RaspSDR/gpsdo/1.jpg

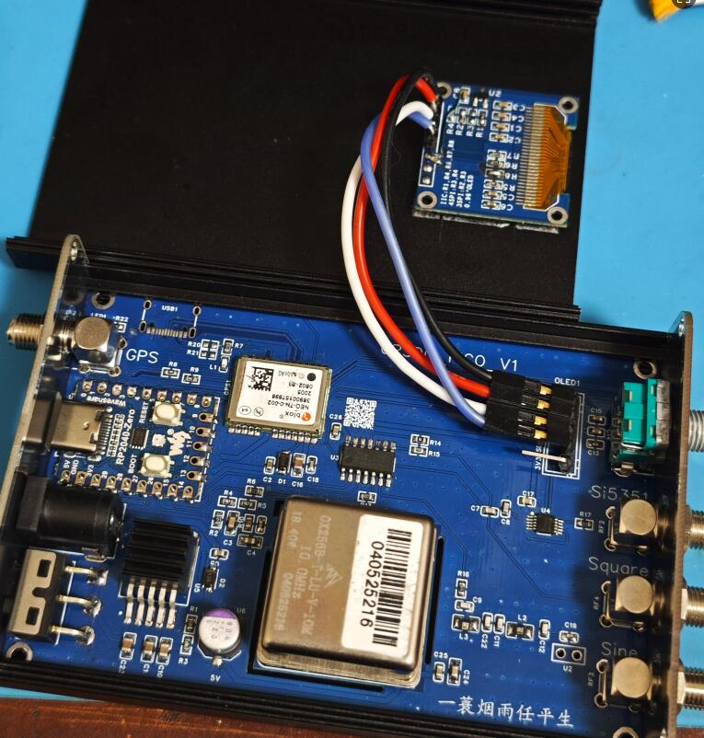
1.jpg
