RaspSDR/gpsdo/2.jpg

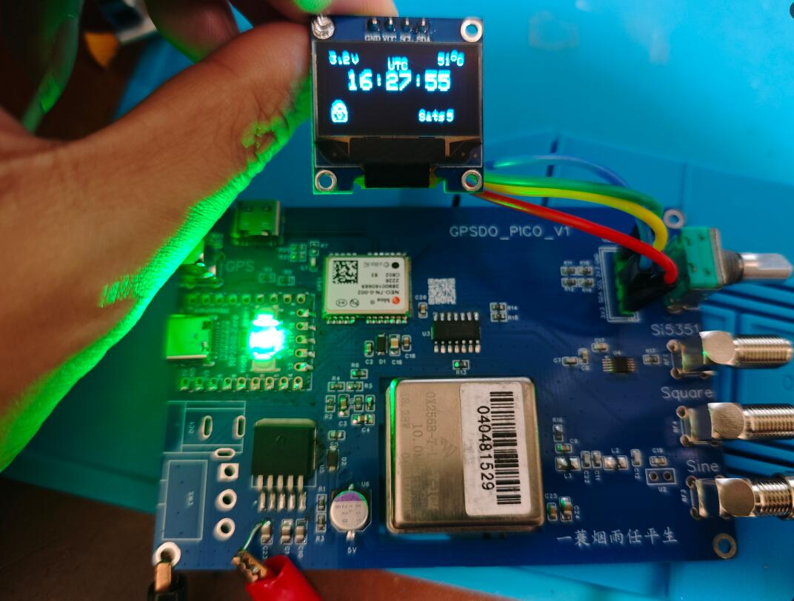
2.jpg
