RaspSDR/gpsdo/BOM_gpsdo_gpsdo_2025-09-10.xlsx

No. | Quantity | Comment | Designator | Footprint | Value | Manufacturer Part | Manufacturer | Supplier Part | Supplier
1 | 4 | 22u | C1,C10,C16,C23 | C0805 | 22u
2 | 11 | 100nF | C2,C5,C6,C13,C14,C15,C17,C18,C19,C25,C26 | C0603 |  | CC0603KRX7R9BB104 | YAGEO | C14663 | LCSC
3 | 3 | 10u | C3,C4,C24 | C0805 | 10u
4 | 2 | 100pF | C7,C8 | C0603 |  | CC0603KRX7R9BB104 | YAGEO | C14663 | LCSC
5 | 3 | 330pF | C9,C12,C22 | C0603 |  | CC0603KRX7R9BB104 | YAGEO | C14663 | LCSC
6 | 1 | 220pF | C11 | C0603 |  | CC0603KRX7R9BB104 | YAGEO | C14663 | LCSC
7 | 2 | B5819WL | D1,D2 | SOD-123F_L2.8-W1.8-LS3.7-RD |  |  | SHIKUES(时科) | C112447 | LCSC
8 | 1 | DC-005-A200 | DC1 | DC-IN-TH_DC-005-A200 |  |  | XUNPU(讯普) | C720557 | LCSC
9 | 1 | NEO-7M-0 | GPS1 | GPS-SMD_NEO-7M-0 |  |  | U-BLOX | C6612031 | LCSC
10 | 1 | 27nH | L1 | L0603 |  |  | muRata(村田) | C162649 | LCSC
11 | 2 | 1uH | L2,L3 | IND-SMD_L2.3-W1.7-1 |  |  | Sunltech(韩国顺磁) | C363974 | LCSC
12 | 1 | XL-1608UGC-04 | LED1 | LED0603-RD_GREEN |  | XL-1608UGC-04 | XINGLIGHT(成兴光) | C965804 | LCSC
13 | 1 | OCXO-5 | O1 | OCXO-5
14 | 1 | DISPLAY-1.54-OLED-128X64-I2C | OLED1 | CONN-TH_XH2.54-5P
15 | 1 | 18K | R1 | R0603 |  | 0603WAF1002T5E | UniOhm | C25804 | LCSC
16 | 1 | 220K | R2 | R0603 |  | 0603WAF1002T5E | UniOhm | C25804 | LCSC
17 | 3 | 56K | R3,R4,R5 | R0603 |  | 0603WAF1002T5E | UniOhm | C25804 | LCSC
18 | 6 | 22R | R6,R8,R9,R11,R12,R13 | R0603 |  | 0603WAF1002T5E | UniOhm | C25804 | LCSC
19 | 1 | 10R | R7 | R0603 |  | 0603WAF1002T5E | UniOhm | C25804 | LCSC
20 | 1 | 75K | R10 | R0603 |  | 0603WAF1002T5E | UniOhm | C25804 | LCSC
21 | 2 | 100R | R14,R15 | R0603 |  | 0603WAF1002T5E | UniOhm | C25804 | LCSC
22 | 2 | 49.9R | R16,R17 | R0603 |  | 0603WAF1002T5E | UniOhm | C25804 | LCSC
23 | 2 | 4.7K | R18,R19 | R0603 |  | 0603WAF1002T5E | UniOhm | C25804 | LCSC
24 | 2 | 5.1K | R20,R21 | R0603 |  | 0603WAF1002T5E | UniOhm | C25804 | LCSC
25 | 2 | 10K | R22,R23 | R0603 |  | 0603WAF1002T5E | UniOhm | C25804 | LCSC
26 | 4 | BWSMA-KWE-Z001 | RF1,RF2,RF3,RF4 | SMA-TH_BWSMA-KWE-Z001 |  |  | BAT WIRELESS(蝙蝠无线) | C496551 | LCSC
27 | 1 | EC11B15242AE | SW2 | SW-TH_EC11B1524XX |  | EC11B15242AE | ALPSALPINE(阿尔卑斯阿尔派) | C470755 | LCSC
28 | 1 | SS-12D06L5 | SW3 | SW-TH_3P-P4.70_L11.1-W12.7 |  | SS-12D06L5 | XKB Connectivity(中国星坤) | C319015 | LCSC
29 | 1 | RP2040-ZERO | U1 | COMM-SMD_RP2040-ZERO |  |  | Waveshare(微雪电子) | C5350143 | LCSC
30 | 1 | HC-PZ254-11.5L-1X2PZ | U2 | CONN-TH_HC-PZ254-11.5L-1X2PZ |  | HC-PZ254-11.5L-1x2PZ | HC(虹成电子) | C27985187 | LCSC
31 | 1 | 74HC86 | U3 | SOP-14
32 | 1 | Si5351A-B-GT | U4 | SI5351A-B-GT-MSOP-10_L3.0-W3.0-P0.50-LS5.0-BL
33 | 1 | LT1963A-adj | U5 | DD-PAK-5_L10.6-W10.3-P1.70-LS14.5-BR |  | LT1963A-adj | Analog Devices | C665682 | LCSC
34 | 1 | 100uF | U6 | CAP-SMD_BD6.3-L6.6-W6.6-LS7.3-FD | 100uF | 118EC221 | KNSCHA(科尼盛) | C5361260 | LCSC
35 | 1 | 33000uF | U7 | BAT-SMD_SM3R3333-T01 | 33000uF | SM3R3333 T01 | KORCHIP(高奇普) | C260765 | LCSC
36 | 1 | TYPE-C 16PIN 2MD(073) | USB1 | USB-C-SMD_TYPE-C-6PIN-2MD-073 |  | TYPE-C 16PIN 2MD(073) | SHOU HAN(首韩) | C2765186 | LCSC
