RaspSDR/gpsdo/SCH_gpsdo_2025-07-16.pdf

# VCC33GND

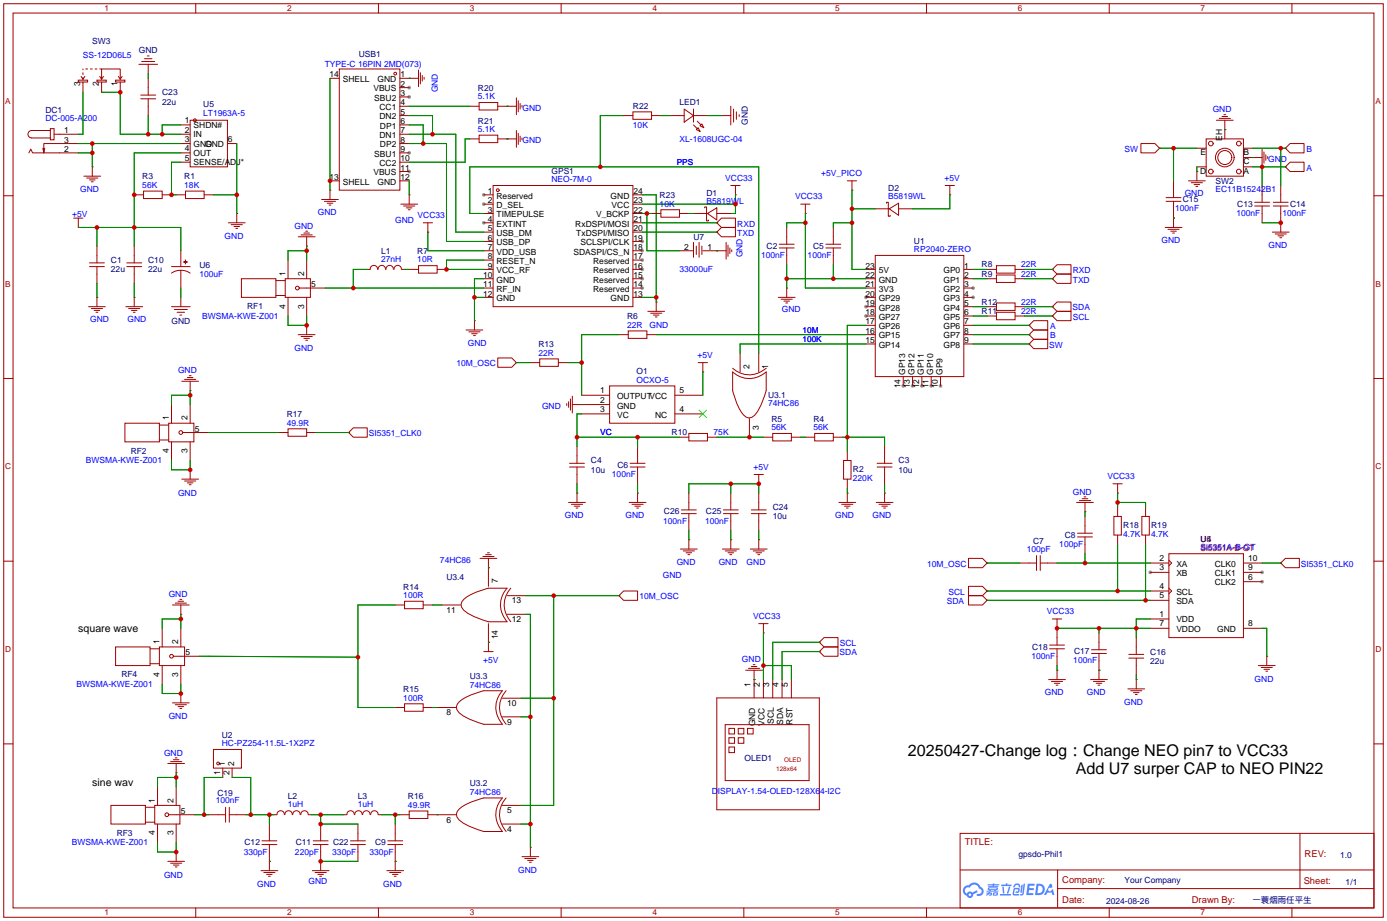
[picture p4: page 1]

20250427-Change log：Change NEO pin7 to VCC33

Add U7 surper CAP to NEO PIN22
