RaspSDR/gpsdo/(list of files, drawings)

Other design files:
ProPrj_gpsdo-Phil1_2025-08-17.epro
